drdpj/MidiKeyboardBluePill/MIDI2M4000/MIDI2M4000.kicad_pcb

## KiCad design MIDI2M4000/MIDI2M4000.kicad_pcb (2019-08-12)

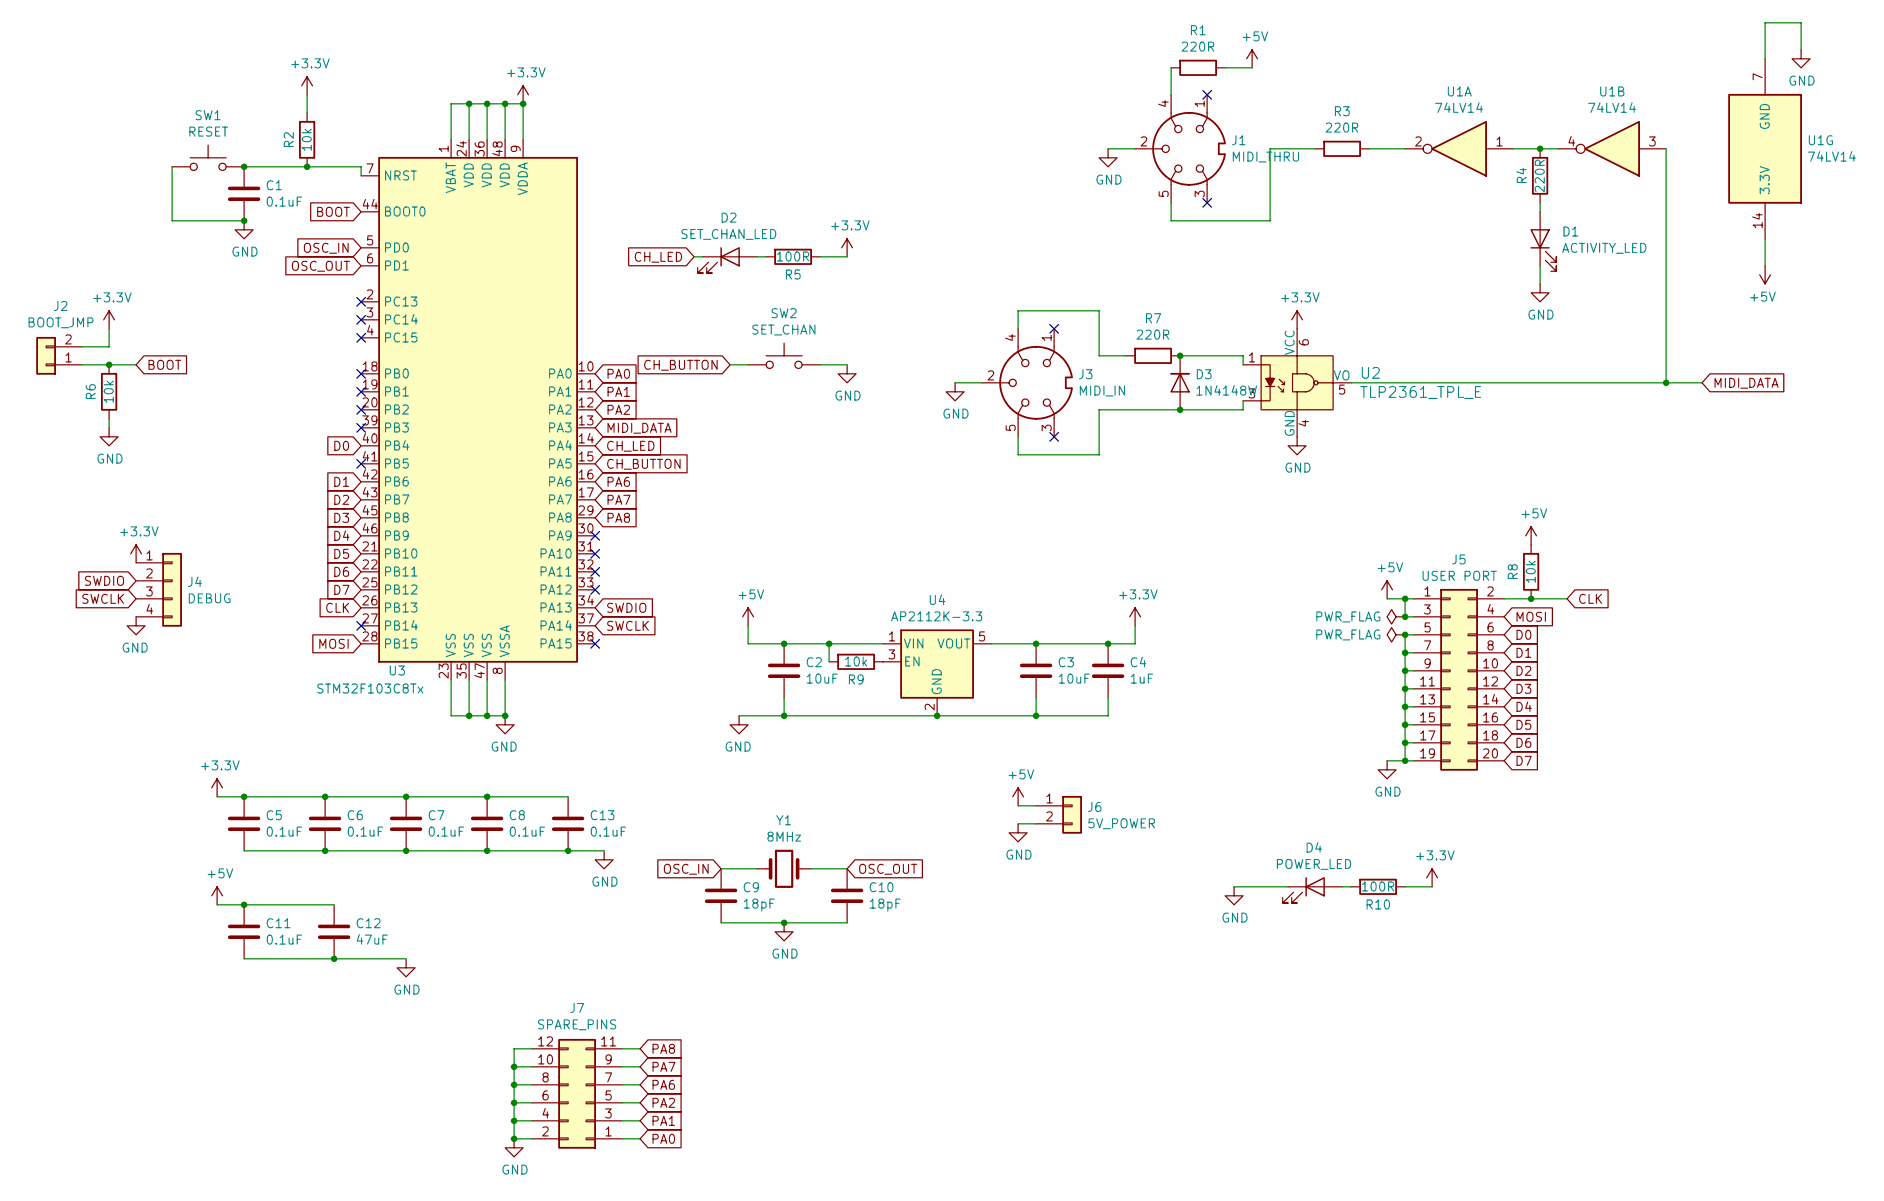
[picture p1: schematic MIDI2M4000.sch, MIDI-2-M4000 converter]

Parts:
C1, C5, C6, C7, C8, C11, C13: 0.1uF; C_0805_2012Metric
C2, C3: 10uF; C_0805_2012Metric
C4: 1uF; C_0805_2012Metric
C9, C10: 18pF; C_0805_2012Metric
C12: 47uF; C_0805_2012Metric
D1: ACTIVITY_LED; PinHeader_1x02_P2.54mm_Vertical
D2: SET_CHAN_LED; PinHeader_1x02_P2.54mm_Vertical
D3: 1N4148W; D_SOD-123
D4: POWER_LED; PinHeader_1x02_P2.54mm_Vertical
J1: MIDI_THRU; din_5_econet_pcb_mount
J2: BOOT_JMP; PinHeader_1x02_P2.54mm_Vertical
J3: MIDI_IN; din_5_econet_pcb_mount
J4: DEBUG; PinHeader_1x04_P2.54mm_Vertical
J5: USER PORT; IDC-Header_2x10_P2.54mm_Horizontal_Lock
J6: 5V_POWER; PinHeader_1x02_P2.54mm_Vertical
J7: SPARE_PINS; PinSocket_2x06_P2.54mm_Vertical
R1, R3, R4, R7: 220R; R_0805_2012Metric
R2, R6, R8, R9: 10k; R_0805_2012Metric
R5, R10: 100R; R_0805_2012Metric
SW1: RESET; PinHeader_1x02_P2.54mm_Vertical
SW2: SET_CHAN; PinHeader_1x02_P2.54mm_Vertical
U1: 74LV14; SOIC-14_3.9x8.7mm_P1.27mm
U2: TLP2361_TPL_E; SOIC-6-5_W4.55mm; MPN TLP2361(TPL,E; Digi-Key_PN TLP2361(TPLECT-ND
U3: STM32F103C8Tx; LQFP-48_7x7mm_P0.5mm
U4: AP2112K-3.3; SOT-23-5
Y1: 8MHz; Crystal_SMD_TXC_7A-2Pin_5x3.2mm

Connections:
+3V3: C3.1, C4.1, C5.1, C6.1, C7.1, C8.1, C13.1, J2.2, J4.1, R2.2, R5.1, R10.1, U2.6 (VCC), U3.1 (VBAT), U3.9 (VDDA), U3.24 (VDD), U3.36 (VDD), U3.48 (VDD), U4.5 (VOUT)
+5V: C2.1, C11.1, C12.1, J5.1, J5.3, J6.1, R1.1, R8.2, R9.2, U1.14 (3.3V), U4.1 (VIN)
BOOT: J2.1, R6.2, U3.44 (BOOT0)
CH_BUTTON: SW2.1, U3.15 (PA5)
CH_LED: D2.1 (K), U3.14 (PA4)
CLK: J5.2, R8.1, U3.26 (PB13)
D0: J5.6, U3.40 (PB4)
D1: J5.8, U3.42 (PB6)
D2: J5.10, U3.43 (PB7)
D3: J5.12, U3.45 (PB8)
D4: J5.14, U3.46 (PB9)
D5: J5.16, U3.21 (PB10)
D6: J5.18, U3.22 (PB11)
D7: J5.20, U3.25 (PB12)
GND: C1.2, C2.2, C3.2, C4.2, C5.2, C6.2, C7.2, C8.2, C9.2, C10.2, C11.2, C12.2, C13.2, D1.1 (K), D4.1 (K), J1.2, J3.2, J4.4, J5.5, J5.7, J5.9, J5.11, J5.13, J5.15, J5.17, J5.19, J6.2, J7.2, J7.4, J7.6, J7.8, J7.10, J7.12, R6.1, SW1.1, SW2.2, U1.7 (GND), U2.4 (GND), U3.8 (VSSA), U3.23 (VSS), U3.35 (VSS), U3.47 (VSS), U4.2 (GND)
MIDI_DATA: U1.3, U2.5 (VO), U3.13 (PA3)
MOSI: J5.4, U3.28 (PB15)
unnamed: C1.1, R2.1, SW1.2, U3.7 (NRST)
unnamed: D1.2 (A), R4.1
unnamed: D2.2 (A), R5.2
unnamed: D3.1 (K), R7.1, U2.1
unnamed: D3.2 (A), J3.5, U2.3
unnamed: D4.2 (A), R10.2
unnamed: J1.4, R1.2
unnamed: J1.5, R3.2
unnamed: J3.4, R7.2
unnamed: R3.1, U1.2
unnamed: R4.2, U1.1, U1.4
unnamed: R9.1, U4.3 (EN)
OSC_IN: C9.1, U3.5 (PD0), Y1.1
OSC_OUT: C10.1, U3.6 (PD1), Y1.2
PA0: J7.1, U3.10 (PA0)
PA1: J7.3, U3.11 (PA1)
PA2: J7.5, U3.12 (PA2)
PA6: J7.7, U3.16 (PA6)
PA7: J7.9, U3.17 (PA7)
PA8: J7.11, U3.29 (PA8)
SWCLK: J4.3, U3.37 (PA14)
SWDIO: J4.2, U3.34 (PA13)

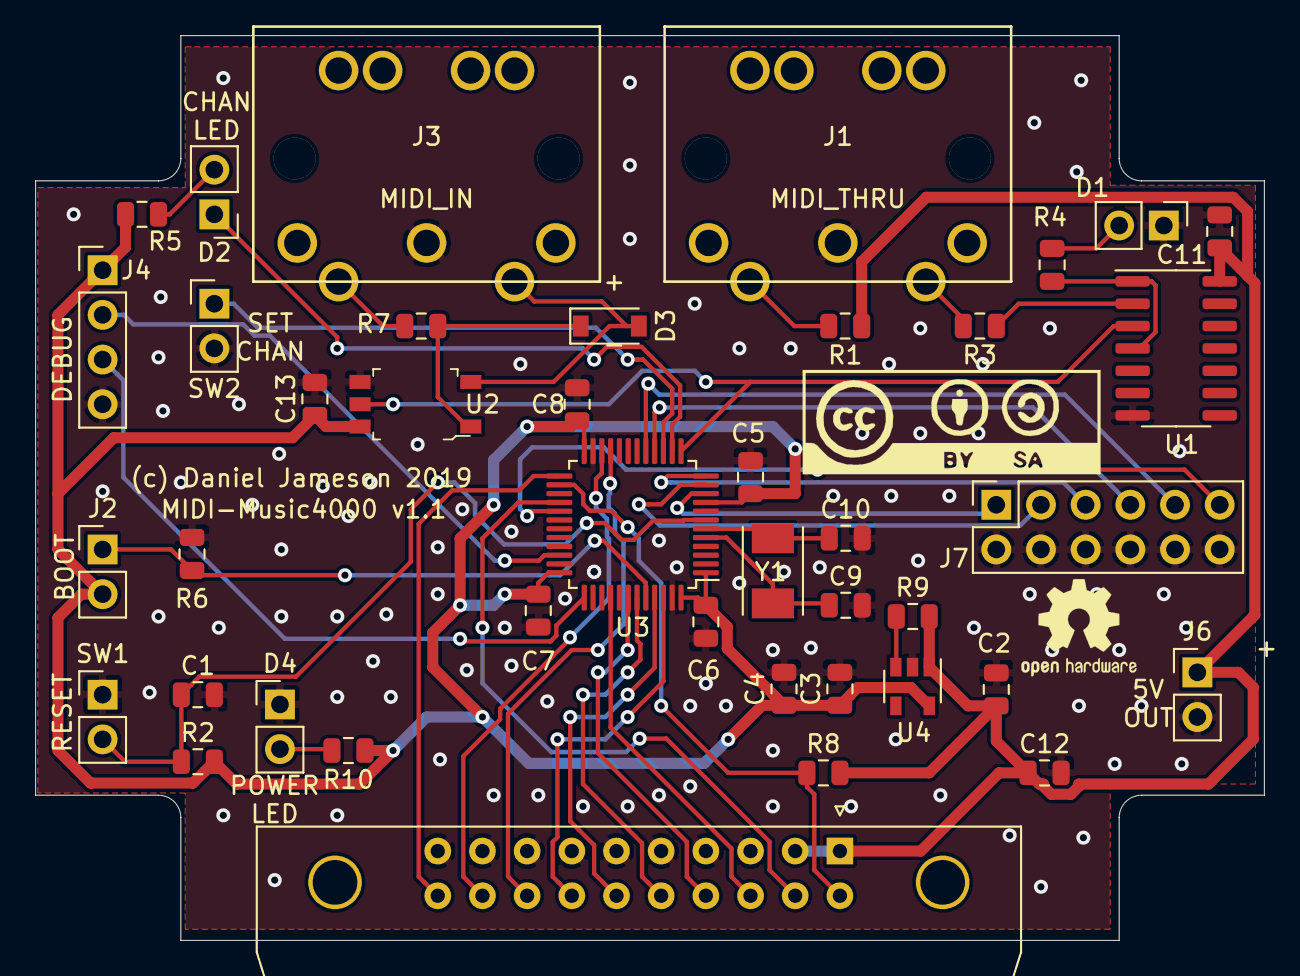
[picture p2: board MIDI2M4000.kicad_pcb from above]

Board: 2 copper layers, 69.8 x 51.4 mm, 41 parts (0 on the bottom side), 39 nets.
