drdpj/MidiKeyboardBluePill/Src/main.c

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
/* Includes ------------------------------------------------------------------*/
#include "main.h"

/* USER CODE BEGIN Includes */
#include "utilities.h"

/* USER CODE END Includes */

SPI_HandleTypeDef hspi2;

UART_HandleTypeDef huart2;

/* USER CODE BEGIN PV */

/* Set Channel Flag */
volatile uint8_t setChannel = FALSE;
volatile uint8_t ignoreChannel = TRUE;
volatile uint8_t midiChannel = 0;

/* This is the keyboard matrix */
uint8_t keyboardMatrix[8];
volatile uint16_t outputArray[8];

/* Some variables used to calculate the key */
uint8_t m4kZone;
uint8_t m4kNote;
uint8_t rawZone;

/* A temporary integer - probably gets optimised out! */

uint8_t tempInt;

/* midi command and state */
uint8_t midiStatus = 0;
uint8_t midiData1 = 0;
uint8_t midiData2 = 0;
uint8_t state = 0;
uint8_t midiByte = 0;


/* USER CODE END PV */

void SystemClock_Config(void);
static void MX_GPIO_Init(void);
static void MX_USART2_UART_Init(void);
static void MX_SPI2_Init(void);

/* USER CODE BEGIN PFP */
inline void parseMidi(void);
inline void Note_On(uint8_t);
inline void Note_Off(uint8_t);

/* USER CODE END PFP */

/**
  * @brief  The application entry point.
  * @retval int
  */
int main(void)
{
  /* USER CODE BEGIN 1 */

  uint8_t i = 0;

  /* all keys high to start with */
  for (i = 0; i < 8; i++)
  {
    keyboardMatrix[i] = 255;
    outputArray[i] = 0xffff;
  }

  /* USER CODE END 1 */

  /* MCU Configuration--------------------------------------------------------*/

  /* Reset of all peripherals, Initializes the Flash interface and the Systick. */
  HAL_Init();

  /* Configure the system clock */
  SystemClock_Config();

  /* Initialize all configured peripherals */
  MX_GPIO_Init();
  MX_USART2_UART_Init();
  MX_SPI2_Init();
  /* USER CODE BEGIN 2 */

  /* enable the SPI and UART - not using the HAL read functions so need to turn them on */
  __HAL_SPI_ENABLE(&hspi2);
  __HAL_UART_ENABLE(&huart2);
  /* USER CODE END 2 */

  /* Infinite loop */
  /* USER CODE BEGIN WHILE */
  while (1)
  {

   
  }

  /* USER CODE END 3 */
}

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
/* USER CODE BEGIN 4 */

inline void parseMidi() 
{

  if ((midiChannel == (midiStatus & MIDI_CHANNEL_MASK)) || ignoreChannel) 
  {
    switch(midiStatus & MIDI_MASK) 
    {
      case MIDI_ON:
        if (setChannel == TRUE)
        {
          midiChannel = midiStatus & MIDI_CHANNEL_MASK;
          setChannel = FALSE;
          ignoreChannel = FALSE;
          HAL_GPIO_WritePin(GPIOA, GPIO_PIN_4, GPIO_PIN_SET);
        }
        if (midiData2) 
        {
          Note_On(midiData1);
        }
        else
        {
          /* Velocity 0 is note off */
          Note_Off(midiData1);
        }
        break;

      case MIDI_OFF:
        Note_Off(midiData1);
        break;

      case MIDI_CONT:
        /* Handle the pedal */
        if (midiData1 == MIDI_PED)
        {
          if (midiData2 < 64) {
            keyboardMatrix[PEDAL_ZONE] |= (1 << 6);
           } 
           else keyboardMatrix[PEDAL_ZONE] &= ~(1 << 6);
        }
        /* Handle the sound off/notes off control commands - everything off! */
        if (midiData1 == MIDI_SOUND_OFF || midiData1 == MIDI_NOTES_OFF) {
          for (uint_fast8_t i = 36; i<85; i++) {
            Note_Off(i);
          }
        }
        break;

        default:
        break;
    }
  }
  for (uint_fast8_t i = 0; i < 8; i++)
  {
    outputArray[i] = ((uint16_t)keyboardMatrix[i] & 1) << 4 | (uint16_t)keyboardMatrix[i] << 5;
  }
}
/* We're only allowing midi notes between 36 and 84 otherwise
 * we'll overshoot the keyboard matrix array...
 */

/**
 * @brief Set Keyboard Key
 * @param uint_8_t MIDInote
 * @retval None
 */

inline void Note_On(uint8_t note)
{

  /**
   * possibly long winded, but!
   * Bounds check the note, calculate which zone it's in,
   * Invert the zone for the keyboard matrix and then
   * flip the relevant bit.
   */

  if ((note > 35) && (note < 85))
  {
    rawZone = ((note - 36) / 8);
    m4kZone = 7 - rawZone;
    m4kNote = note - 36 - (8 * rawZone);

    keyboardMatrix[m4kZone] &= ~(1 << m4kNote);
  }
}

/**
 * @brief Set Keyboard Key
 * @param uint_8_t MIDInote
 * @retval None
 */

inline void Note_Off(uint8_t note)
{
  if ((note > 35) && (note < 85))
  {
    rawZone = ((note - 36) / 8);
    m4kZone = 7 - rawZone;
    m4kNote = note - 36 - (8 * rawZone);

    keyboardMatrix[m4kZone] |= (1 << m4kNote);
  }
}



/* USER CODE END 4 */
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
