drdpj/MidiKeyboardBluePill/Inc/main.h

#define MIDI_CHANNEL_MASK 0b00001111
#define MIDI_MASK 0b11110000
#define MIDI_ON 0b10010000
#define MIDI_OFF 0b10000000
#define MIDI_CONT 0b10110000
#define MIDI_PED 64
#define MIDI_NOTES_OFF 123
#define MIDI_SOUND_OFF 120 
#define PEDAL_ZONE 0
#define FALSE 0
#define TRUE 1
#define program_led_Pin GPIO_PIN_4
#define program_led_GPIO_Port GPIOA
#define button_Pin GPIO_PIN_5
#define button_GPIO_Port GPIOA
