drdpj/MidiKeyboardBluePill/(commit log)

2019-05-26 Updated to use 5V tolerant GPIOs. Code commented in more detail.
2019-05-29 All 5V tolerant inputs now, updated code to cope. Compiles fine with -O2, updated description of required hardware.
2019-06-09 Implemented software debounce for channel select button.
2019-06-25 Adding PCB Design - CC-BY-SA 4.0
    [MIDI2M4000.csv, MIDI2M4000.kicad_pcb, MIDI2M4000.sch]
2019-06-28 Added another decoupler for optoisolator.
    [MIDI2M4000.kicad_pcb, MIDI2M4000.sch]
2019-06-29 Logos back on PCB
    [MIDI2M4000.kicad_pcb]
2019-07-17 Shrunk PCB, v1.1
    [MIDI2M4000.kicad_pcb]
2019-08-12 Revised LED Resistor Values
    [MIDI2M4000.csv, MIDI2M4000.kicad_pcb, MIDI2M4000.sch]
2023-01-20 Reset clocks in .ioc file.
    [MidiKeyboardBluePill.ioc]
