drdpj/MidiKeyboardBluePill/(notices)

Notices in the files:
Src/main.c:
© Copyright (c) 2019 STMicroelectronics.
All rights reserved.
This software component is licensed by ST under BSD 3-Clause license,
the "License"; You may not use this file except in compliance with the
License. You may obtain a copy of the License at:
Copyright (C) 2019-2024 Daniel Jameson
MIDI2M4000/MIDI2M4000.kicad_pcb:
(c) Daniel Jameson 2019 CC-BY-SA 4.0
MIDI2M4000/MIDI2M4000.sch:
(c) 2019 Daniel Jameson
License: CC-BY-SA 4.0
